urjaman/tprobe/README

This is a logic probe from an ATtiny85V thingy,
just for the lulz.
