urjaman/tprobe/hw_kicad/tprobe.kicad_pcb

## KiCad design hw_kicad/tprobe.kicad_pcb (2017-03-27)

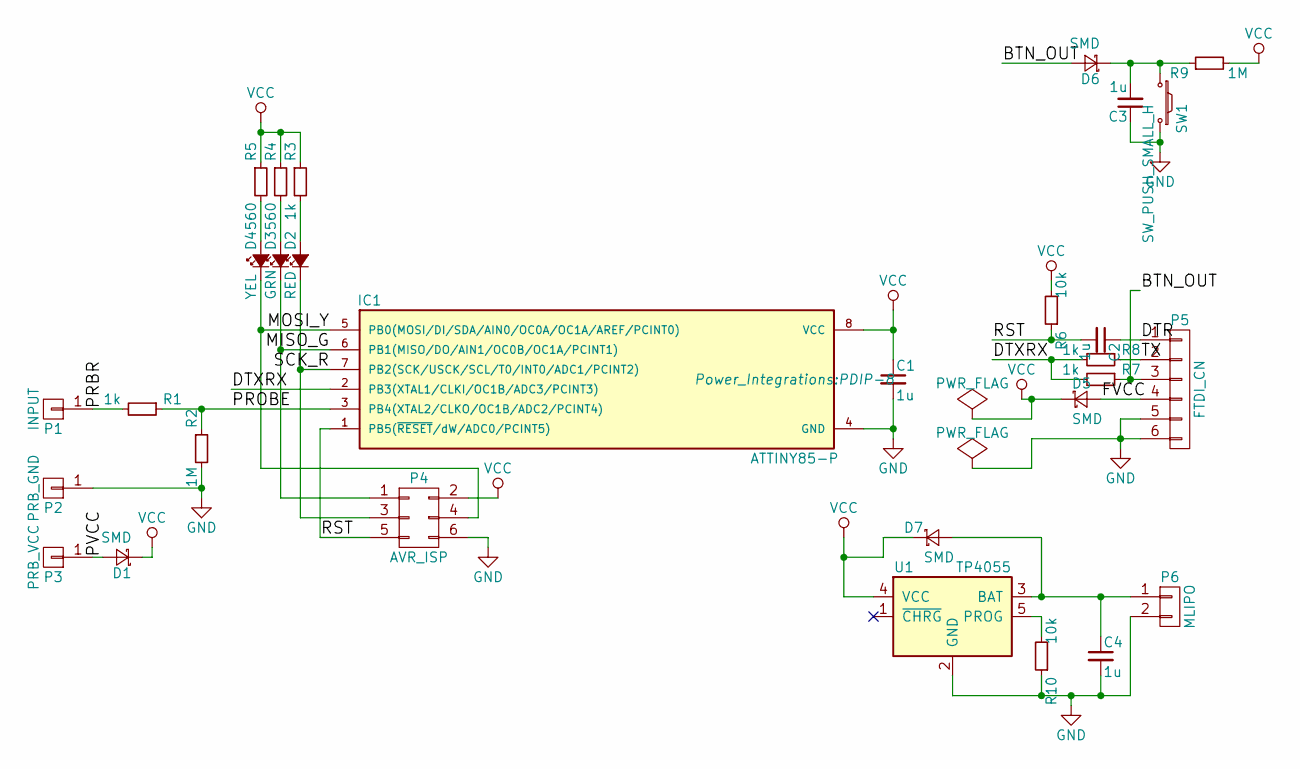
[picture p1: schematic tprobe.sch]

Parts:
C1, C2, C3, C4: 1u; C_0603_HandSoldering
D1, D5, D6, D7: SMD; SOD-323_HandSoldering
D2: RED; LED-3MM
D3: GRN; LED-3MM
D4: YEL; LED-3MM
IC1: ATTINY85-P; PDIP-8
P1: INPUT; SolderWirePad_single_2mmDrill
P2: PRB_GND; SolderWirePad_single_2mmDrill
P3: PRB_VCC; SolderWirePad_single_2mmDrill
P4: AVR_ISP; Pin_Header_Straight_2x03
P5: FTDI_CN; Socket_Strip_Angled_1x06
P6: MLIPO; Pin_Header_Straight_1x02
R1, R3, R7, R8: 1k; R_0603_HandSoldering
R2, R9: 1M; R_0603_HandSoldering
R4, R5: 560; R_0603_HandSoldering
R6, R10: 10k; R_0603_HandSoldering
SW1: SW_PUSH_SMALL_H; SW_PUSH_6mm
U1: TP4055; SOT-23-5

Connections:
/BTN_OUT: D6.2 (A), P5.3, R7.1
/DTR: C2.1, P5.1
/DTXRX: IC1.2 (PB3(XTAL1/CLKI/OC1B/ADC3/PCINT3)), R7.2, R8.2
/FVCC: D5.2 (A), P5.4
/MISO_G: D3.1 (K), IC1.6 (PB1(MISO/DO/AIN1/OC0B/OC1A/PCINT1)), P4.1
/MOSI_Y: D4.1 (K), IC1.5 (PB0(MOSI/DI/SDA/AIN0/OC0A/OC1A/AREF/PCI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), P4.4
/PRBR: P1.1, R1.2
/PROBE: IC1.3 (PB4(XTAL2/CLKO/OC1B/ADC2/PCINT4)), R1.1, R2.1
/PVCC: D1.2 (A), P3.1
/RST: C2.2, IC1.1 (PB5(~RESET~/dW/ADC0/PCINT5)), P4.5, R6.1
/SCK_R: D2.1 (K), IC1.7 (PB2(SCK/USCK/SCL/T0/INT0/ADC1/PCINT2)), P4.3
/TX: P5.2, R8.1
GND: C1.2, C3.1, C4.2, IC1.4 (GND), P2.1, P4.6, P5.5, P5.6, P6.2, R2.2, R10.1, SW1.2, U1.2 (GND)
unnamed: C3.2, D6.1 (K), R9.1, SW1.1
unnamed: C4.1, D7.2 (A), P6.1, U1.3 (BAT)
unnamed: D2.2 (A), R3.2
unnamed: D3.2 (A), R4.2
unnamed: D4.2 (A), R5.2
unnamed: R10.2, U1.5 (PROG)
VCC: C1.1, D1.1 (K), D5.1 (K), D7.1 (K), IC1.8 (VCC), P4.2, R3.1, R4.1, R5.1, R6.2, R9.2, U1.4 (VCC)

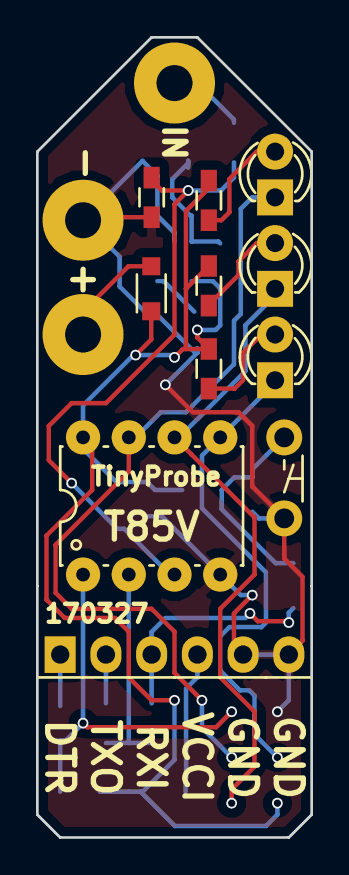
[picture p2: board tprobe.kicad_pcb from above]

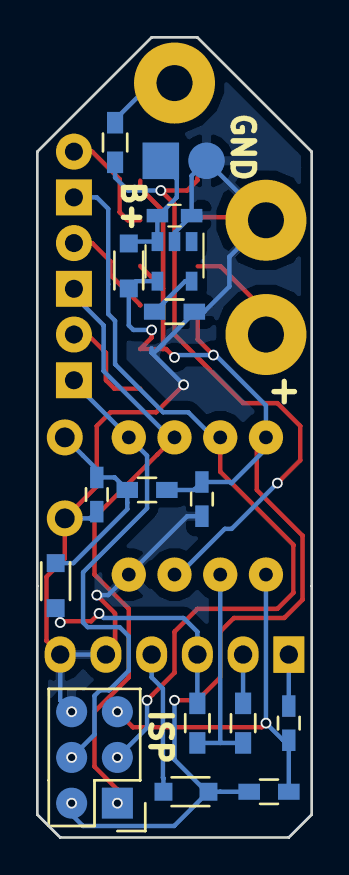
[picture p3: board tprobe.kicad_pcb from below]

Board: 2 copper layers, 15.2 x 44.5 mm, 30 parts (16 on the bottom side), 20 nets.
