urjaman/tprobe/serialprogrammer.c

/*
 * Copyright (C) 2011,2013,2017,2018 Urja Rannikko <urjaman@gmail.com>
 *
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
 */

#include <stdio.h>
#include <stdlib.h>
#include <sys/types.h>
#include <sys/stat.h>
#include <fcntl.h>
#include <unistd.h>
#include <errno.h>
#include <termios.h>
#include <string.h>
#include <inttypes.h>
#include <sys/ioctl.h>

#define MAX_FRAME 257

struct baudentry {
	int flag;
	unsigned int baud;
};
#define BAUDENTRY(baud) { B##baud, baud },

static const struct baudentry sp_baudtable[] = {
	BAUDENTRY(9600) /* unconditional default */
#if defined(B19200)
	BAUDENTRY(19200)
#endif
#if defined(B38400)
	BAUDENTRY(38400)
#endif
#if defined(B57600)
	BAUDENTRY(57600)
#endif
#if defined(B115200)
	BAUDENTRY(115200)
#endif
#if defined(B230400)
	BAUDENTRY(230400)
#endif
#if defined(B460800)
	BAUDENTRY(460800)
#endif
#if defined(B500000)
	BAUDENTRY(500000)
#endif
#if defined(B576000)
	BAUDENTRY(576000)
#endif
#if defined(B921600)
	BAUDENTRY(921600)
#endif
#if defined(B1000000)
	BAUDENTRY(1000000)
#endif
#if defined(B1152000)
	BAUDENTRY(1152000)
#endif
#if defined(B1500000)
	BAUDENTRY(1500000)
#endif
#if defined(B2000000)
	BAUDENTRY(2000000)
#endif
#if defined(B2500000)
	BAUDENTRY(2500000)
#endif
#if defined(B3000000)
	BAUDENTRY(3000000)
#endif
#if defined(B3500000)
	BAUDENTRY(3500000)
#endif
#if defined(B4000000)
	BAUDENTRY(4000000)
#endif
	{0, 0}			/* Terminator */
};

void set_baudrate(int fd, unsigned int baud) {
	int i;
	struct termios options;
	int bro = -1;
	for (i=0;sp_baudtable[i].baud;i++) {
		if (sp_baudtable[i].baud == baud) {
			bro = i;
			break;
		}
	}
	if (bro==-1) {
		printf("Cannot set baud rate %d\n",baud);
		exit(10);
	}
	tcgetattr(fd,&options);
	cfsetispeed(&options, sp_baudtable[bro].flag);
	cfsetospeed(&options, sp_baudtable[bro].flag);
	tcsetattr(fd, TCSANOW, &options);
}

/* command generation */
#define TAG_CHAR 0x55
#define INIT_CMD 0xAA
#define EXIT_CMD 0xFF

#define MAX_SIZE 65536
static uint8_t buffer[MAX_SIZE];

int open_devfd(char * fn) {
	struct termios options;
	int fd;
	fd = open(fn,O_RDWR|O_NOCTTY|O_NDELAY);
	if (fd == -1) {
		printf("Serial open fail\n");
		exit(2);
	}
	fcntl(fd, F_SETFL, 0);
	tcgetattr(fd,&options);
	cfsetispeed(&options, B115200);
	cfsetospeed(&options, B115200);
	options.c_cflag |= (CLOCAL | CREAD);
	options.c_cflag &= ~PARENB;
	options.c_cflag &= ~CSTOPB;
	options.c_cflag &= ~CSIZE;
	options.c_cflag &= ~CRTSCTS;
	options.c_cflag |= CS8;
	options.c_lflag &= ~(ICANON|ECHO|ECHOE|ISIG |IEXTEN);
	options.c_iflag &= ~(IXON | IXOFF | IXANY | ICRNL | IGNCR | INLCR);
	options.c_oflag &= ~OPOST;
	options.c_cc[VTIME] = 0;

	tcsetattr(fd, TCSANOW, &options);
	int tmp = TIOCM_DTR;
	ioctl(fd,TIOCMBIC,&tmp);
	sleep(1);
	ioctl(fd,TIOCMBIS,&tmp); /* setting DTR = 1 */

	return fd;
}

void dev_read(int fd, void*buf, int count) {
	int rc = 0;
	do {
		int i = read(fd,buf+rc,count-rc);
		if (i <= 0) {
			printf("Read failed %d (%d/%d)\n",i,rc,count);
			exit(6);
		}
		rc += i;
	} while (rc<count);
}

void dev_write(int fd, const void*buf, int count) {
	uint8_t vbuf[MAX_FRAME];
	int i = write(fd,buf,count);
	if (i != count) {
		printf("Write failed\n");
		exit(5);
	}
	dev_read(fd,vbuf,count); // this hw echoes everything, suppress echos by verifying what we wrote
	if (memcmp(vbuf, buf, count)!=0) {
		const uint8_t *sbuf = buf;
		for (int n=0;n < count; n++) if (sbuf[n] != vbuf[n]) {
			printf("Write verify from echo failed: n=%d, sent 0x%02X rcvd 0x%02X\n",
				n, sbuf[n], vbuf[n]);
			break;
		}
		exit(5);
	}
}


void dev_reset(int devfd) {
	unsigned char c = EXIT_CMD;
	dev_write(devfd,&c,1); /* dev reset, bb */
	int tmp = TIOCM_DTR;
	ioctl(devfd,TIOCMBIC,&tmp);
}

int main(int argc, char * argv[]) {
	int argvbase=1;
	uint8_t c;
	int devfd, flashfd, i, datasz, pagesz;
	if (argc < 3) {
		printf("Usage: %s flash_file serial_device\n",argv[0]);
		exit(1);
	}
	devfd = open_devfd(argv[argvbase+1]);
	printf("Connected.\n");
	sleep(1);
	tcflush(devfd,TCIFLUSH);
	flashfd = open(argv[argvbase],O_RDWR);
	if (flashfd == -1) {
		printf("Flash file open fail\n");
		exit(3);
	}
	memset(buffer,0xFF,MAX_SIZE);
	datasz = read(flashfd,buffer,MAX_SIZE);
	if (datasz < 1) {
		printf("Flash file read fail\n");
		exit(4);
	}
	close(flashfd);
	c = INIT_CMD;
	dev_write(devfd, &c, 1);
	dev_read(devfd, &c, 1);
	if (c != TAG_CHAR) {
		printf("Read invalid - 0x%02X\n",(int)c);
		exit(7);
	}
	dev_read(devfd, &c, 1);
	pagesz = c;
	if (pagesz == 0) pagesz = 256;
	if (datasz&(pagesz-1)) datasz = (datasz&(~(pagesz-1)))+pagesz;
	printf("Entered programming mode.\nPagesize = %d. We have %d pages to write.\n",pagesz,datasz/pagesz);

	for (i = 0; i < datasz; i += pagesz) {
		uint8_t frame[MAX_FRAME];
		frame[0] = i/pagesz;
		memcpy(frame+1, buffer+i, pagesz);
		dev_write(devfd, frame, pagesz+1);
		dev_read(devfd, &c, 1);
		if (c != TAG_CHAR) {
			printf("\nRead invalid - 0x%02X '%c'\n",(int)c, ((signed char)c)<0x20?'.':c);
			dev_reset(devfd);
			exit(8);
		}
		printf("%03d/%03d\r", (i/pagesz)+1, datasz/pagesz);
		fflush(stdout);
	}
	dev_reset(devfd);
	close(devfd);
	printf("\nDone.\n");
	return 0;
}
