urjaman/tprobe/(commit log)

2017-03-19 hw only initial commit
    [tprobe.kicad_pcb, tprobe.sch]
2017-03-22 fricking make sure we reset the thing
    [serialprogrammer.c]
2017-03-22 WDT-based sleepy timer stuff tested
2017-03-22 first probe-implementing code
2017-03-24 change the interrupts to asm
2017-03-27 It deserves a real li-ion charger :)
    [tprobe.kicad_pcb, tprobe.sch]
2017-03-28 sleepier adc
2018-04-09 fix alignment of buffers in probeuart.S
2018-04-09 Only UART tx if we're powered
    this should optimize idle battery runtime...
2018-04-10 Implement tri-tap menu and basic alternative mode switching
    No alternative modes have been implemented yet, so
    it's only a toy menu and a mode that disables the logic probe
    Also added a brainstorming textfile about the menu, so maybe
    the usage logic goes through :P
2018-04-10 Implement a deep sleep mode
    It disables pretty much everything except the async pin change interrupts,
    and should bring the AVR down to the 1µA range, in theory.
    Note: BOD sleep wasnt planned to be used with these fuse settings,
    and officially it might not come out of the sleep sanely - but
    i dont really care if it ends up resetting or something, and well
    we are disabling the brownout detector anyways... in my tests
    it seemed to work fine, but i dont even know if it's implemented
    on the rev of my ATtiny85V lol - i should test, and also i should
    measure the current ... but my accurate multimeter is AWOL, sigh.
    [main.c]
2018-04-11 Add a funsie 'Flashlight' mode 5
    I just need a power-burning dummy mode and it's kinda fun to
    turn all the LEDs on so ... :P
    [main.c]
2018-04-11 Add an activity timer to deep sleep the thing after 3 hours unused
    I mean, in theory this should make the battery last pretty much
    forever (11 years lol) if you forget the thingy somewhere. In theory.
2018-04-14 Disable probe char (with 'N' to signify no data) when probe is disabled
2018-04-17 Implement alt mode 4: 15.625Hz (nominal) square wave output
    also make mode 5 transmit a steady 1,
    it kinda makes sense with the flashlight :P
2018-04-17 fix the UART if switching between modes
    [main.c]
2018-04-18 Reorganize UART tx, implement ADC alt. modes
2018-10-13 fix termios bug in serialprogrammer, clean it up a little
    [serialprogrammer.c]
2018-10-13 Implement sub-modes to free some main modes for more functionality later
    The alt mode map is now like this:
    - mode 1: ADC readouts
    - submode 1: full range (1.8/3.3/5V check)
    - submode 2: low range (1.5 V battery check)
    - submode 3: high range (Lipo battery check)
    - mode 2: free
    - mode 3: free
    - mode 4: 15.625 Hz output (when you just need a signal)
    - mode 5: Leds set ("flashlight"), output 1 (ext. led tester)
    - mode 6: Vcc check (5 seconds)
    - mode 7: Deep sleep, output 0
2018-10-14 Implement diode test mode (also slightly optimize ADC)
    next: autocalibrating diode test mode
    ... i'm thinking you'd just switch to submode 2
    and hold the probes together and it'd count down
    a few seconds on the LEDs and then set the calib
    and switch back to submode 1.
2018-10-14 Implemented runtime calibration of the diodetest
    The thing is able to tell a short from a diode and a LED from a traditional diode,
    and also very crudely approximate (+- 20% ?) resistor values
    in the 200 ohm ... 330 k range (those only over serial, mostly for debug)
    Anyways the calibration is submode 2 of mode 2, and it
    only needs you to hold the probe to ground for a sec and then
    let go for another.
    [main.c]
2018-10-14 Add the docs i wrote when implementing diode test
2018-10-18 Implement higher-speed PWM submodes of previous mode 4 as mode 3
    Mode 1 is still the slow sleepy 15.625 Hz (without timer) :)
2018-10-21 Make the soft uart adaptive to bit edges
    Most of the commands and things you might want to send
    to the device have an edge in them, so this should
    help if your AVR RC OSC happens to be near the tolerance
    for an UART, even if it's not a perfect solution
    - there is calibration for that :P
    (TODO still on saving that, lol)
2018-10-21 un-break the PWM, add adjustable timeout to numeric entry
2018-10-22 Implement ohm magnitude readout on the LEDs
    That is mode 2 submode 2, moved the diode/ohm mode
    calibration to submode 3.
    Now you can have some idea of the ohms even without UART :P
2018-10-23 add variable duty PWM ability
